OE9SAU/SAULink9_Node_Case/README.md

# SAULink9 Node Case
Front cover, back cover and base plate for aluminium housing (see partlist), fit all part´s you need to build up a SAULink9 Repeater Node for SVX- and EchoLink use.

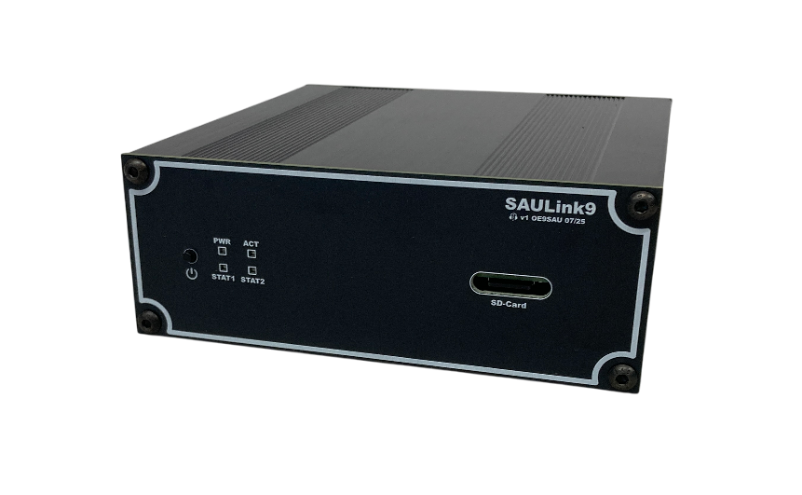
[picture p1: SAULink9_over_front.png]
Caseoverfront

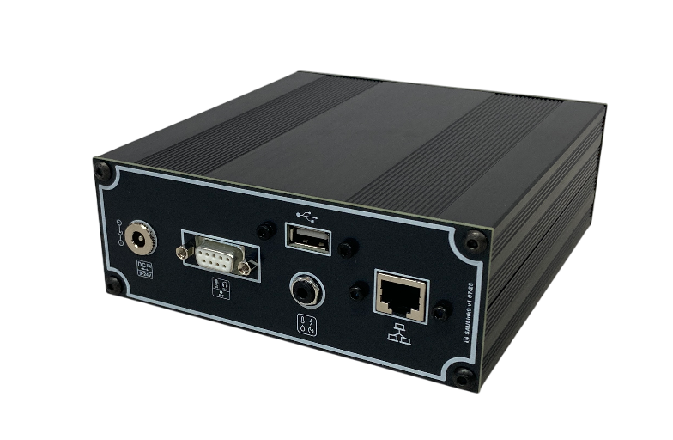
[picture p2: SAULink9_over_back.png]
Caseoverback
