OE9SAU/SAULink9_Node_Case/Node_assembly/SAULink9_Pinout.docx

1-Wire jack socket

1 | GND
2 | 5V
3 | Data
4 | ------

1-Wire jack plug

5V

Data

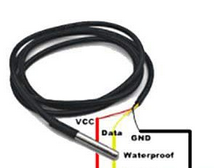
[picture p3: figure]

Sub-D (Blick von hinten auf die Buchse)

Sub-D | Farbe
1 | shield | GND
2 | black | PTT, Aktiv LOW
4 | red | CTCSS/SQL
7 | white | Output = TX Audio
9 | green | Input = RX Audio

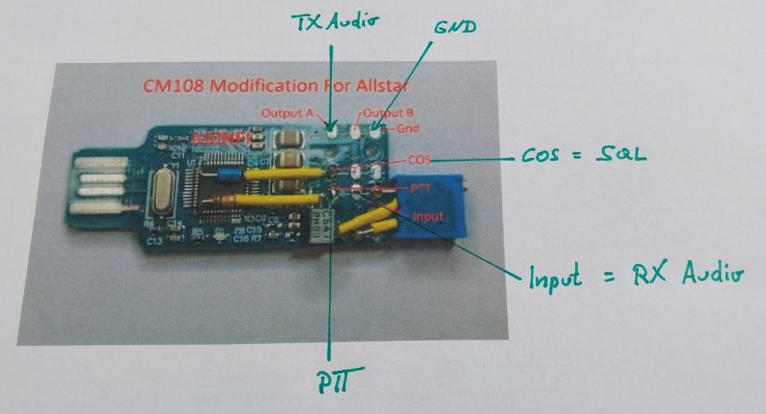
[picture p4: figure]

SAULink9 Pinout
