OE9SAU/SAULink9_Node_Case/Node_Case_back/DC_IN.png

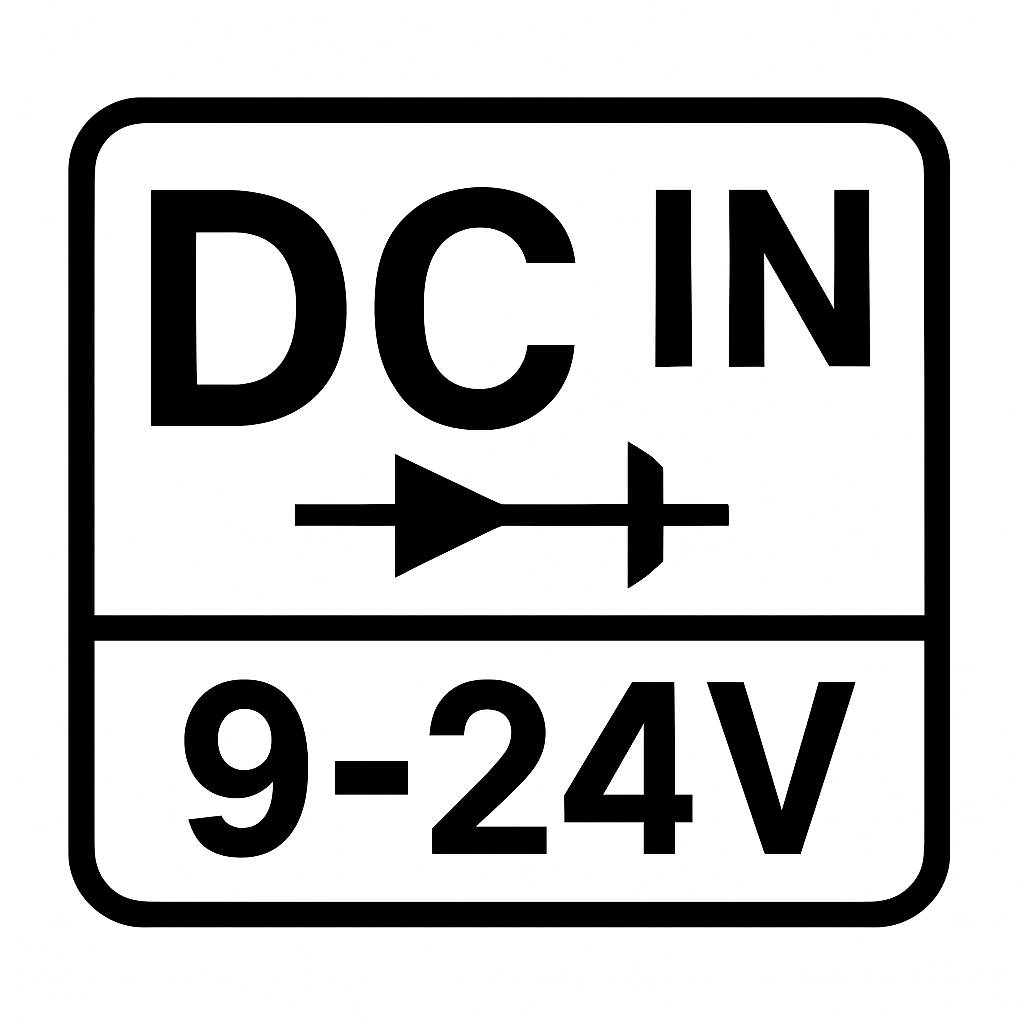
Node_Case_back/DC_IN.png
