OE9SAU/SAULink9_Node_Case/Node_Case_back/Hohlstecker-Polarität.png

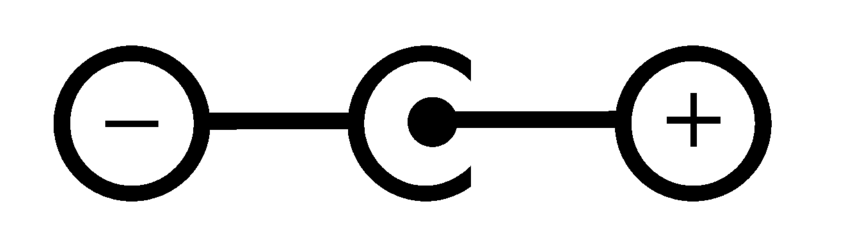
Node_Case_back/Hohlstecker-Polarität.png
