OE9SAU/SAULink9_Node_Case/Node_Case_back/IN_OUT.png

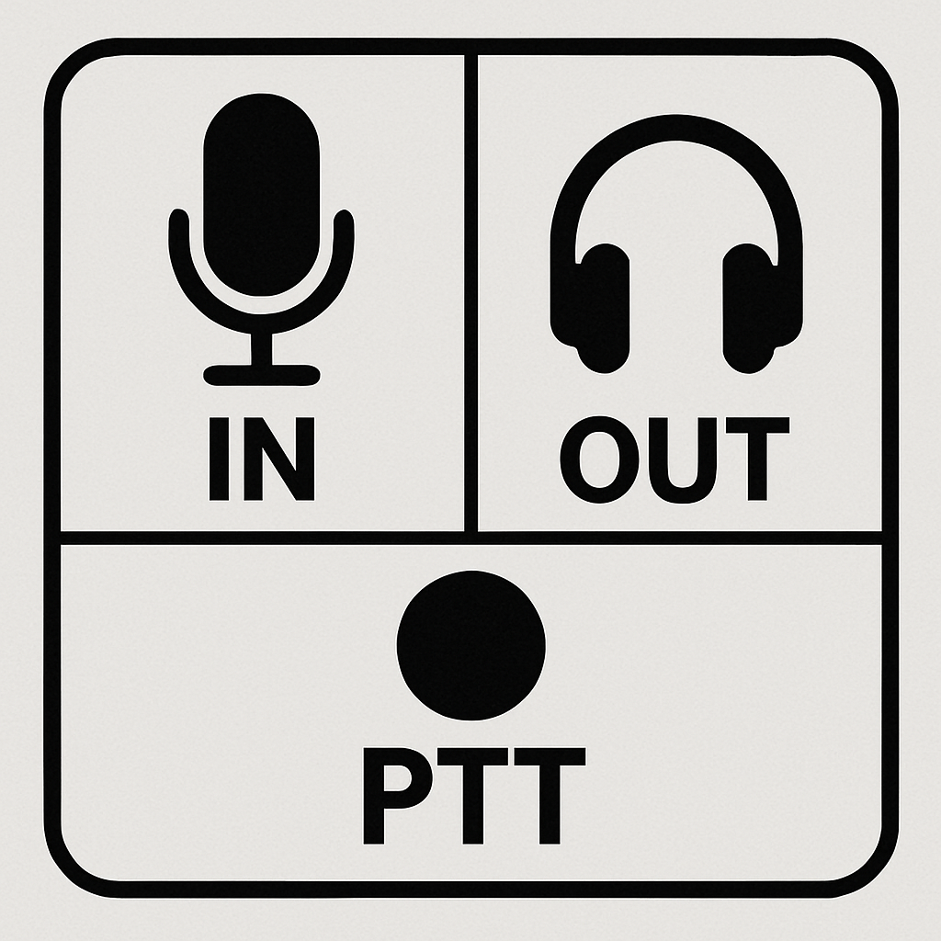
Node_Case_back/IN_OUT.png
