OE9SAU/SAULink9_Node_Case/Node_Case_back/iot.png

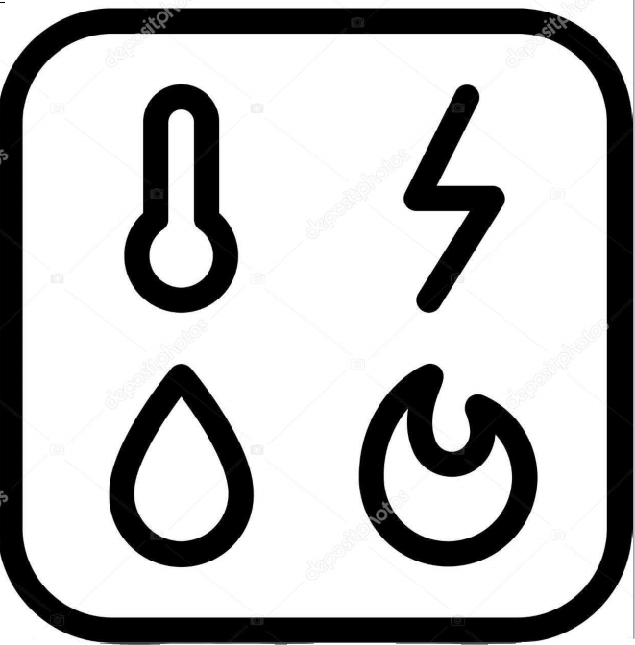
Node_Case_back/iot.png
