OE9SAU/SAULink9_Node_Case/Node_Case_back/lan-netzwerk.png

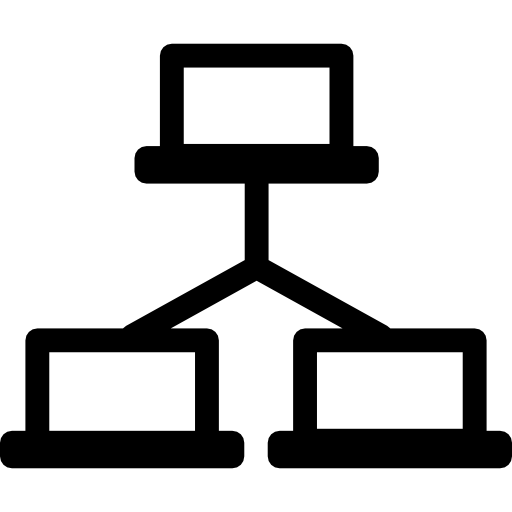
Node_Case_back/lan-netzwerk.png
