OE9SAU/SAULink9_Node_Case/Node_Case_back/on-off-button.png

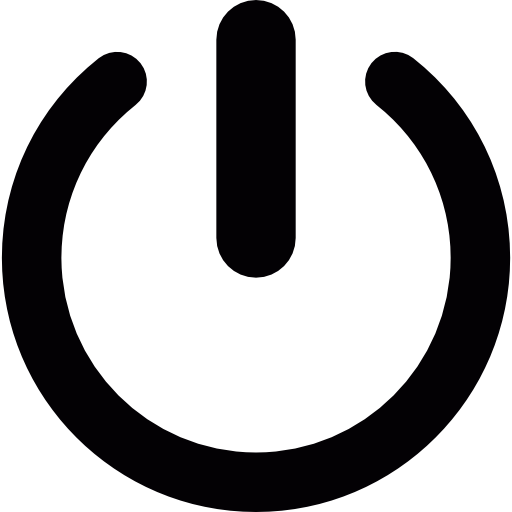
Node_Case_back/on-off-button.png
