OE9SAU/SAULink9_Node_Case/Node_Case_back/SAULink9_back.png

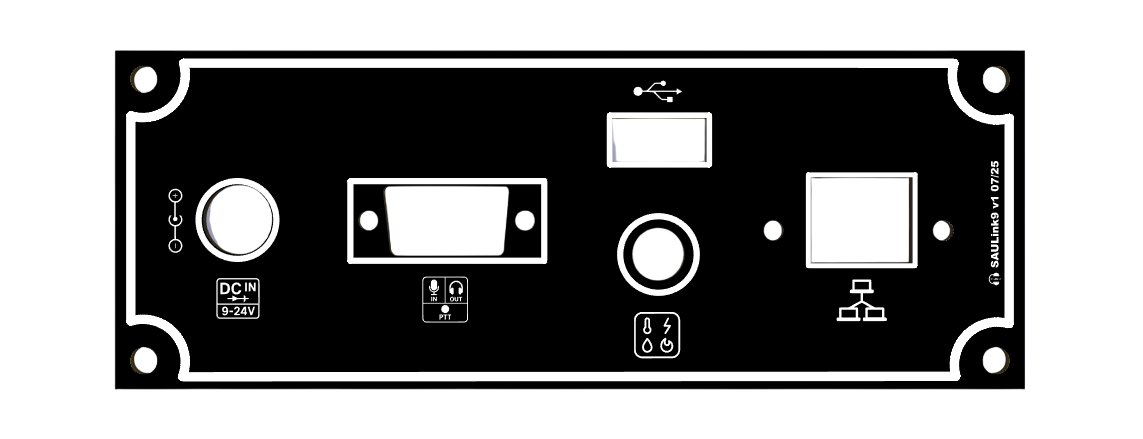
Node_Case_back/SAULink9_back.png
