OE9SAU/SAULink9_Node_Case/Node_Case_back/USB.png

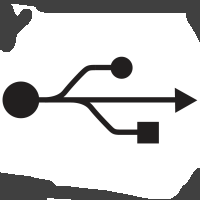
Node_Case_back/USB.png
