OE9SAU/SAULink9_Node_Case/Node_Case_baseplate/SAULink9_baseplate.png

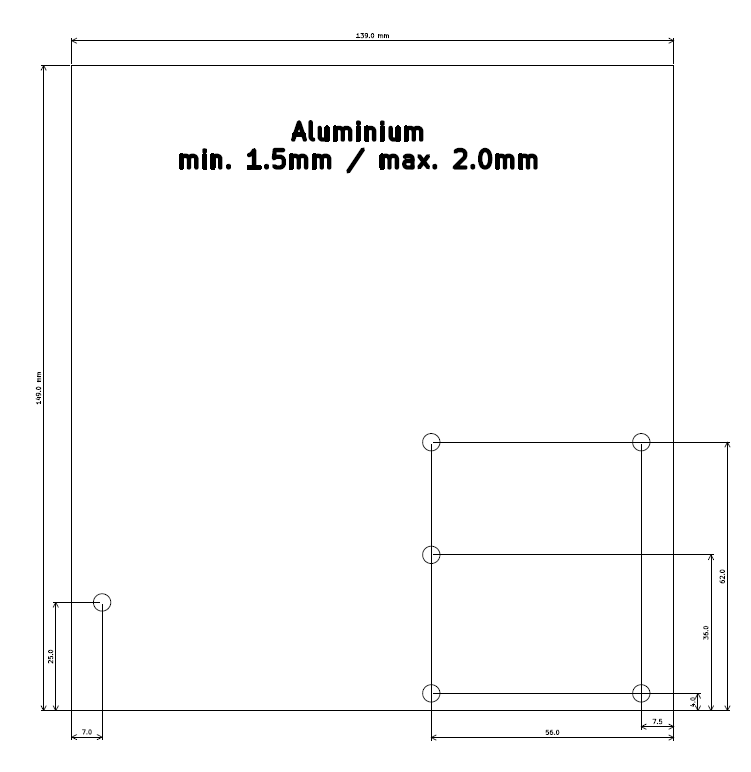
Node_Case_baseplate/SAULink9_baseplate.png
