OE9SAU/SAULink9_Node_Case/Node_Case_front/SAULink9_front.png

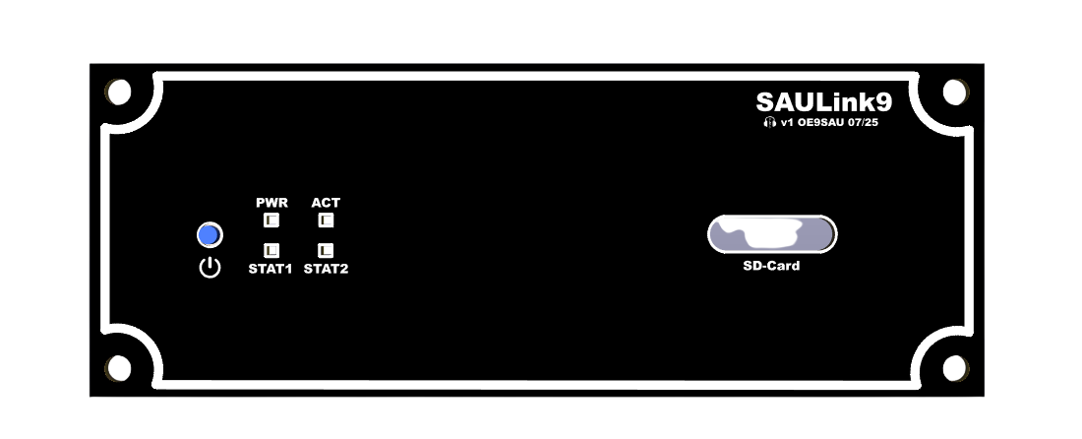
Node_Case_front/SAULink9_front.png
