OE9SAU/SAULink9_Node_Case/SAULink9_PartList.xlsx

Teile | Preis | Amazon
Alu Gehäuse 150*145*54 | EUR 20.56 | https://www.amazon.de/dp/B08DG2X7K5?ref=ppx_yo2ov_dt_b_fed_asin_title
Base plate for case |  | DIY
Front Panel | EUR 2.50 | https://github.com/OE9SAU/SVXLink_Node_Case
Back Panel | EUR 2.50 | https://github.com/OE9SAU/SVXLink_Node_Case
SVXLink Pi Hat | EUR 2.50 | https://github.com/OE9SAU/SVXLink_PiHat_v2
DC-DC 5V/5A | EUR 3.20 | https://www.amazon.de/dp/B0D1K83XRZ?ref=ppx_yo2ov_dt_b_fed_asin_title
USB-Soundcard | EUR 7.50 | https://www.amazon.de/dp/B087V62BYH?ref=ppx_yo2ov_dt_b_fed_asin_title
RJ45 plug to socket (30cm) | EUR 6.24 | https://www.amazon.de/dp/B01EF000NM?ref=ppx_yo2ov_dt_b_fed_asin_title
Klinkeneinbaubuchse | EUR 0.67 | https://www.amazon.de/dp/B09NDP25YY?ref=ppx_yo2ov_dt_b_fed_asin_title
USB Pigtail | EUR 1.41 | https://www.amazon.de/dp/B0D2VMSMGC?ref=ppx_yo2ov_dt_b_fed_asin_title&th=1
SD Card (16gb) | EUR 7.00 | https://www.amazon.de/gp/product/B08KSSX9PH/ref=ewc_pr_img_1?smid=A1G2FC5CI8M2YB&th=1
 |  | Reichelt
Rpi3b+ | EUR 38.22 | RASPBERRY PI 3B+
DC Einbaubuchse | EUR 1.21 | HEBLM 25
DC Stecker | EUR 0.23 | HS 25-9
D-Sub 9pol | EUR 0.18 | D-SUB BU 09
D-Sub Schraubsverriegelungssatz | EUR 1.16 | BKL 10120291
Schottkydiode, 30 V, 0,2 A, DO-35 | EUR 0.05 | BAT 43 STM
Bipolartransistor, NPN, 45V, 0,1A, 0,5W, TO-92 LF | EUR 0.07 | BC547CTA
Widerstand, Metallschicht, 4,70 kOhm, 0207, 0,6 W, 1% | EUR 0.07 | METALL 4,70K
Präzisionspotentiometer, 25 Gänge, liegend, 50 kOhm (nur bei Motorola) | EUR 0.24 | 64P-50K
JST - Buchsengehäuse, RM 2,5 mm, 1x6 polig, gew. - XH | EUR 0.45 | JST XH6P SM4
Taster, SMD, 1 Schließer (NO) | EUR 0.33 | OMR B3FS-1012P
Kleinmaterial SMD Widerstände, Abstandshalter, Drähte, usw. | EUR 10.00
 | EUR 106.29
