OE9SAU/SAULink9_Node_Case/Node_assembly/SAULink9_assembly.docx

1) mount DC-DC power supply to baseplate

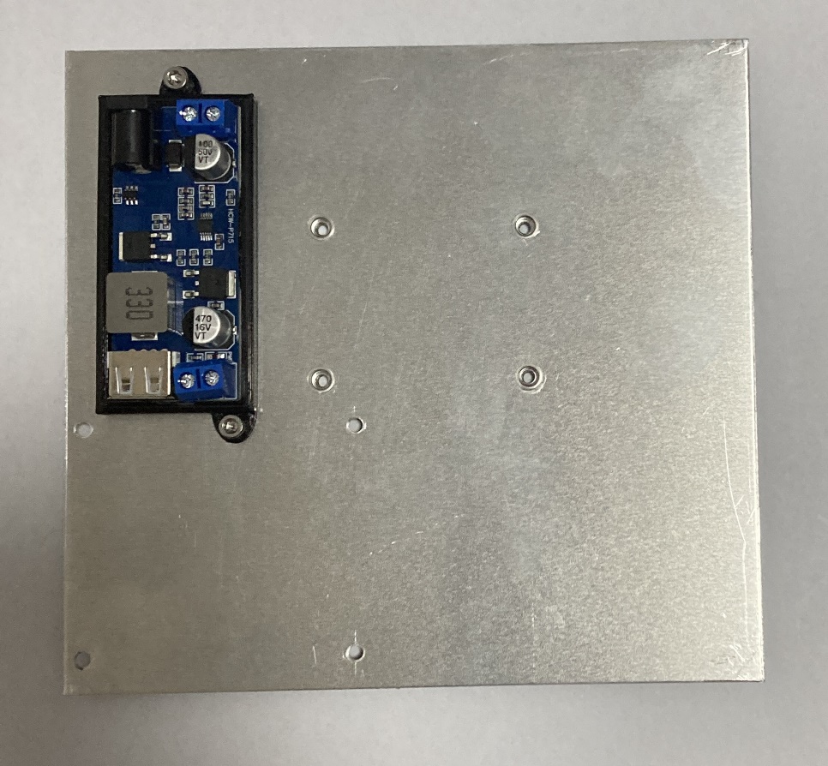
[picture p15: figure]

2) solder USB pigtail to RPI

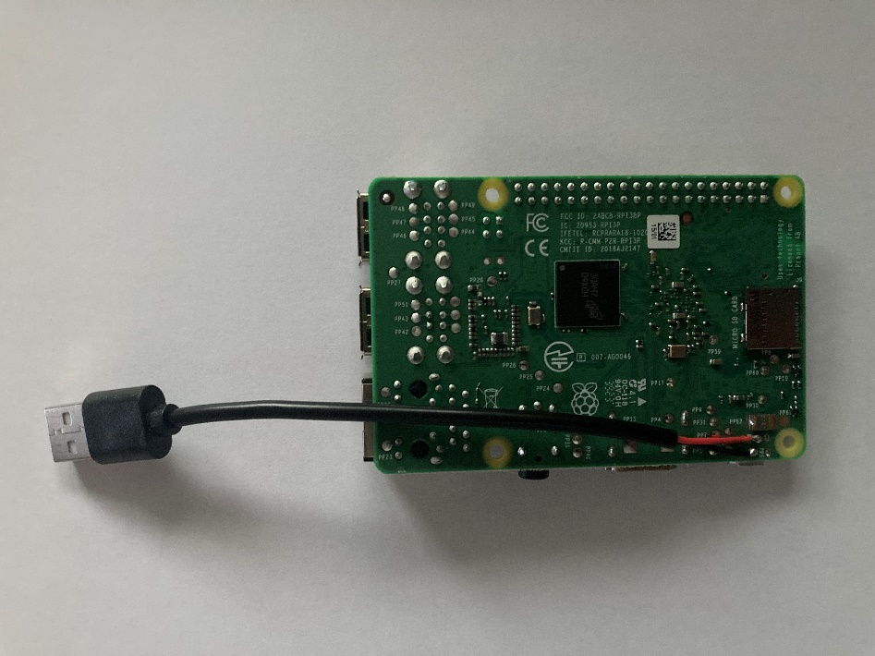
[picture p16: figure]
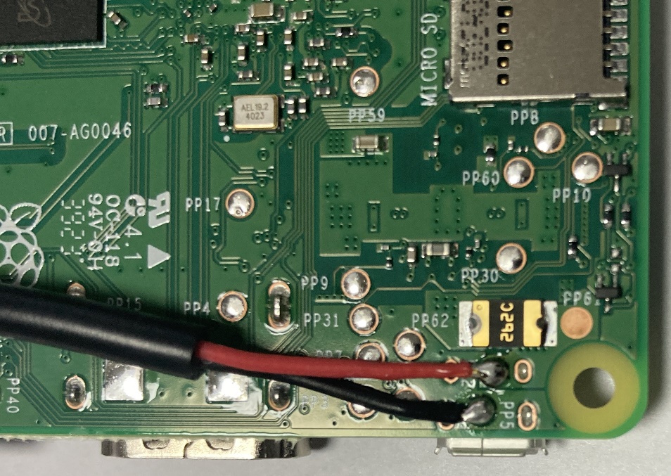
[picture p17: figure]
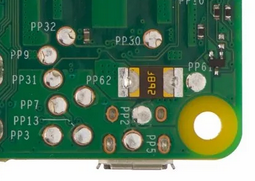
[picture p18: figure]

PP5 = GND (black) // PP2 = 5V (red)

3) Mount RPI with spacer to base plate

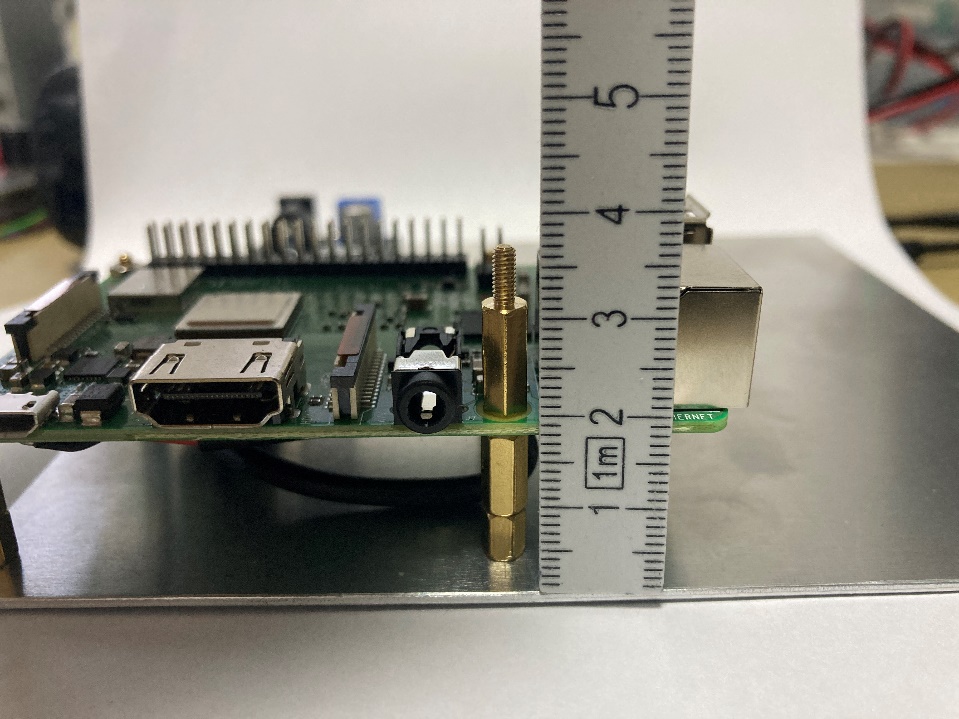
[picture p19: figure]

use 2.5x16+6 (4x) / 8x Nylon Flat // 2.5*12+6 (4x) / 2x M2.5 Nuts or similar high

4) Assemble and attach pihat to RPI with spacer (see above)

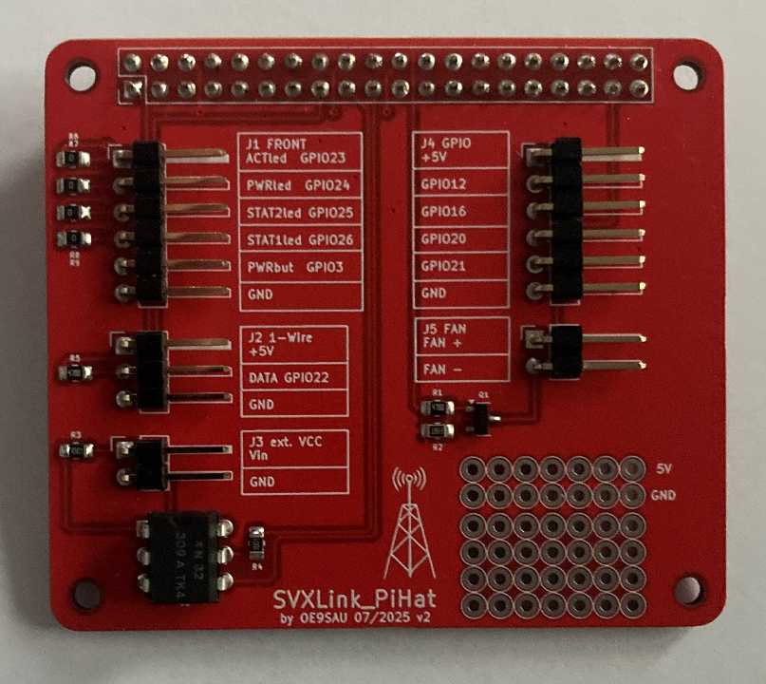
[picture p20: figure]
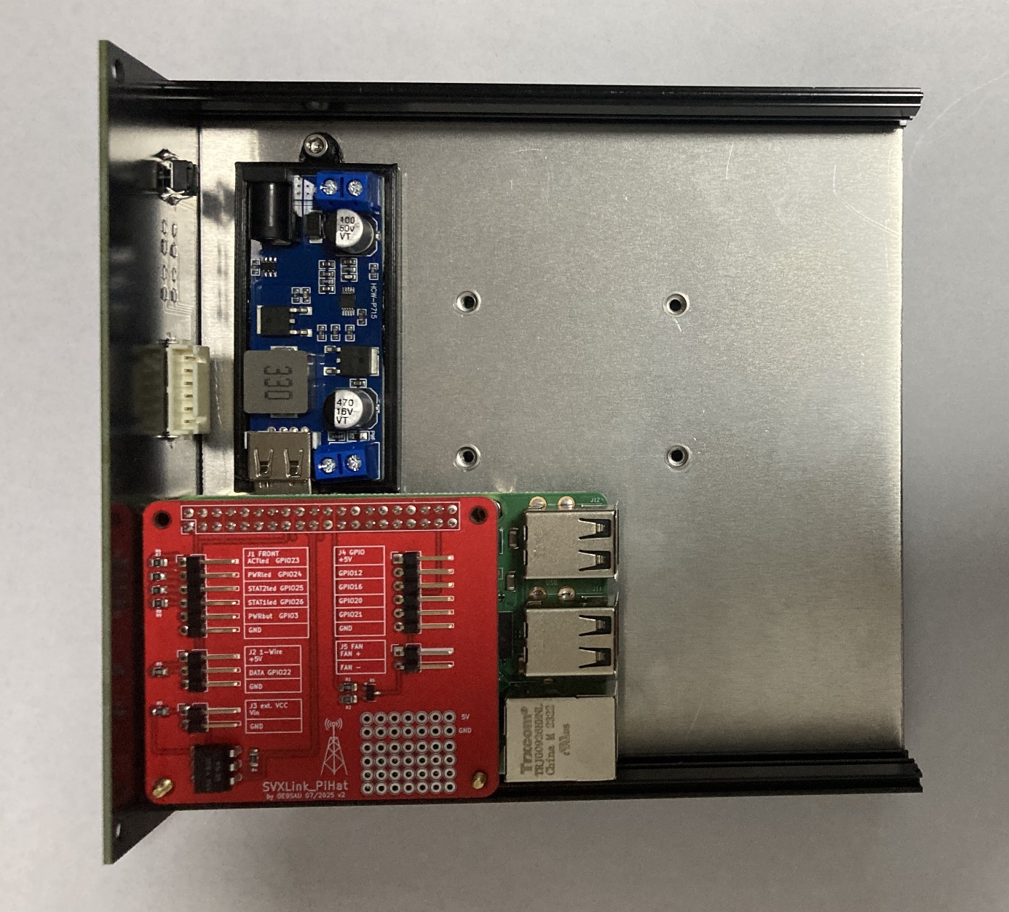
[picture p21: figure]

5) connecting front plate

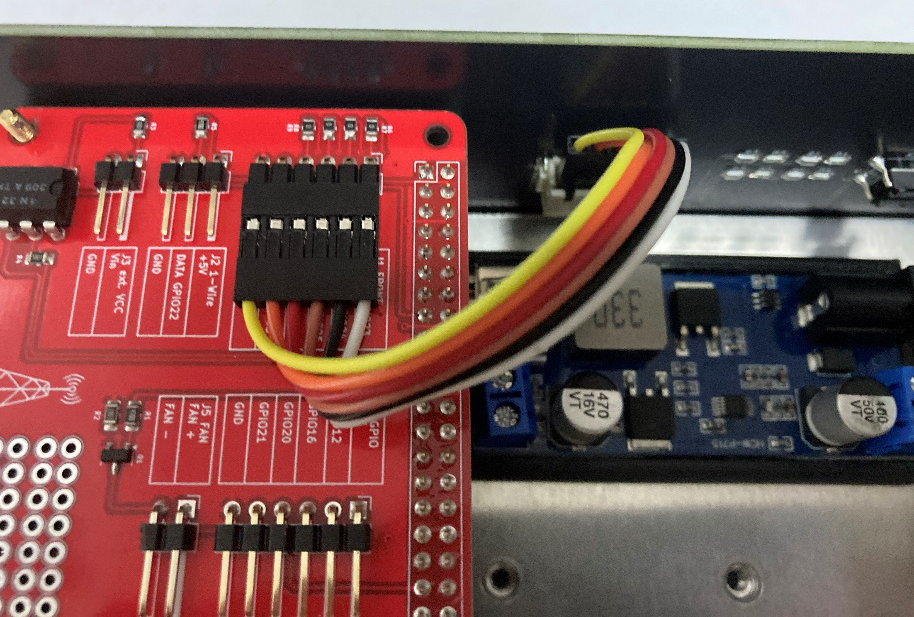
[picture p22: figure]
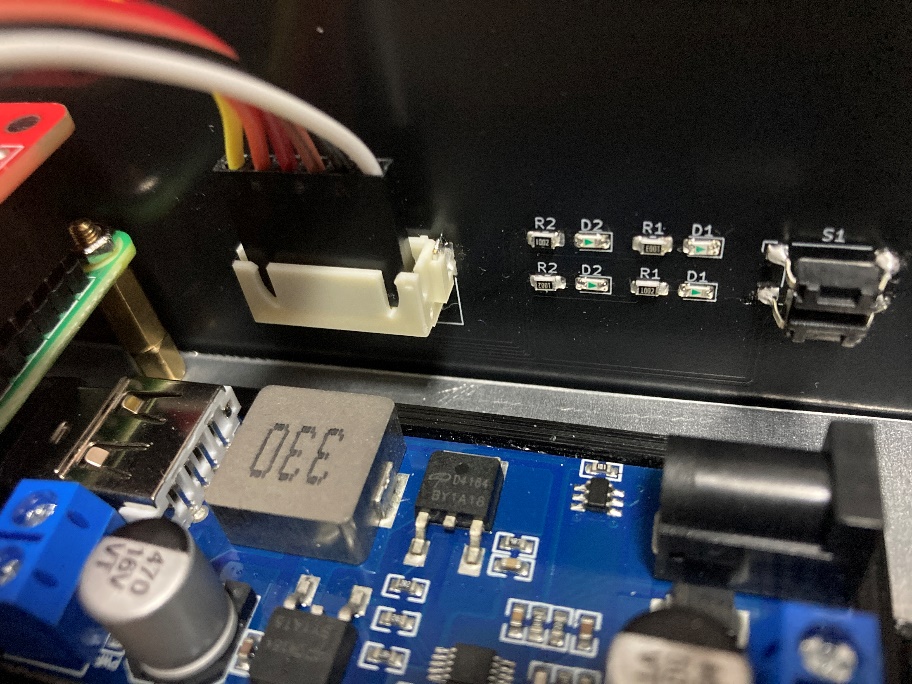
[picture p23: figure]
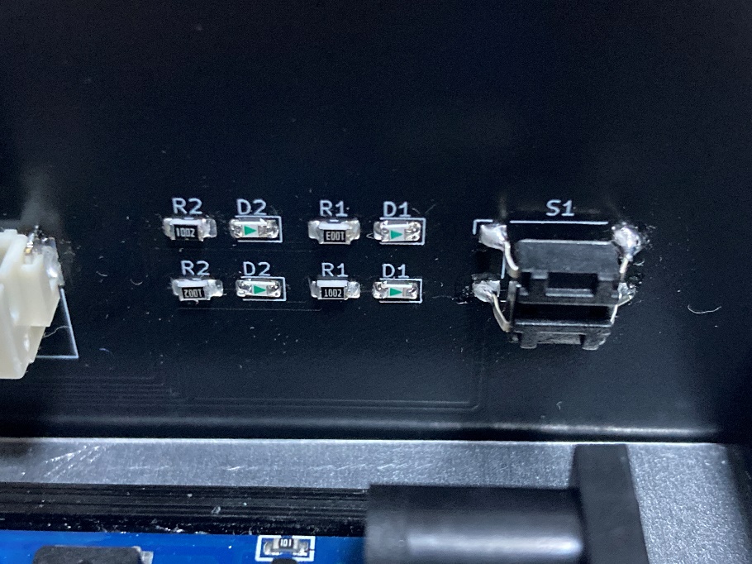
[picture p24: figure]

7) connectors for backplate

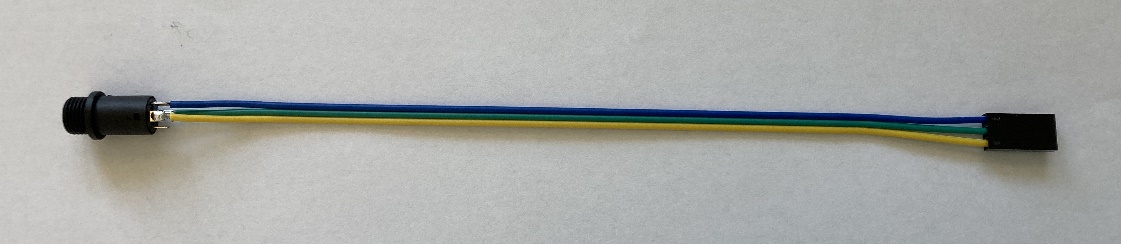
[picture p25: figure]

1-Wire jack socket

1 | GND
2 | 5V
3 | Data
4 | ------

1-Wire jack plug

5V

Data

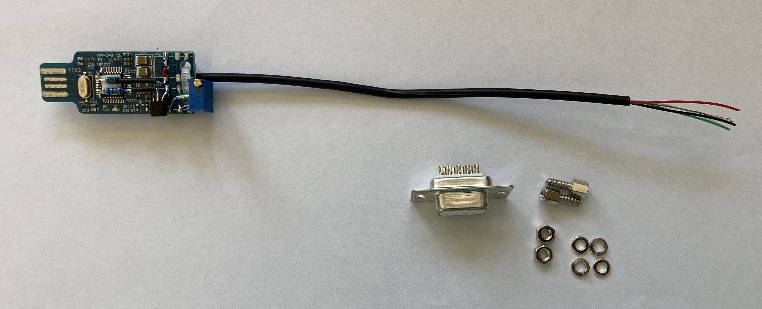
[picture p26: figure]
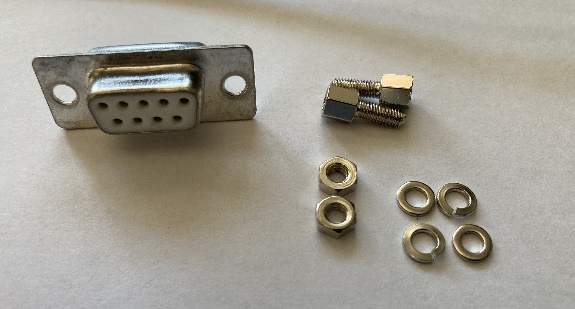
[picture p27: figure]

Sub-D | Farbe
1 | shield | GND
2 | black | PTT, Aktiv LOW
4 | red | CTCSS/SQL
7 | white | Output = TX Audio
9 | green | Input = RX Audio

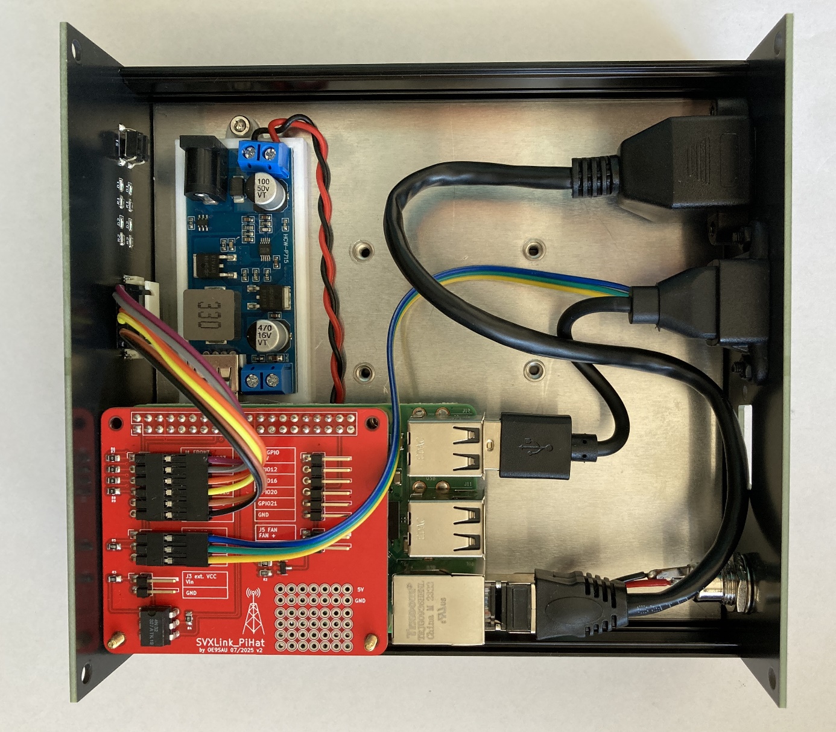
[picture p28: figure]

SAULink9 assembly
