OE9SAU/SAULink9_Node_Case/Node_assembly/pics/IMG_1199.JPG

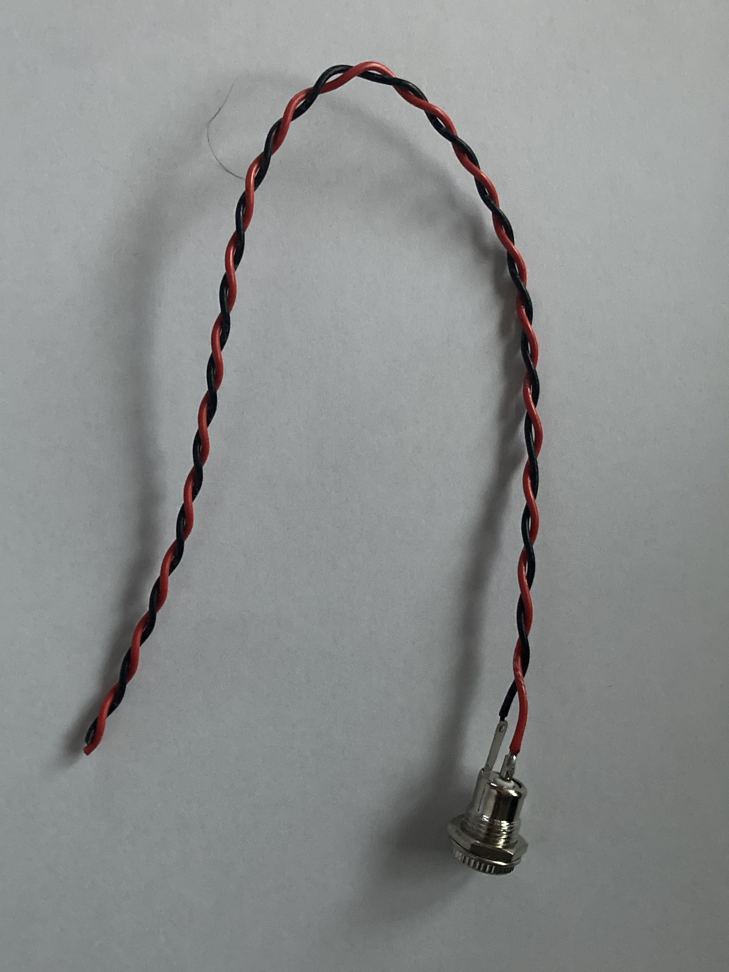
Node_assembly/pics/IMG_1199.JPG
