OE9SAU/SAULink9_Node_Case/(commit log)

2025-07-25 PCB upd
    [SVX_Node_Case_front.kicad_pcb]
2025-07-27 update pcb
    [SVX_Node_Case_back-B_Cu.gbr, SVX_Node_Case_back-B_Mask.gbr, SVX_Node_Case_back-B_Paste.gbr, SVX_Node_Case_back-B_Silkscreen.gbr, SVX_Node_Case_back-Edge_Cuts.gbr, SVX_Node_Case_back-F_Cu.gbr, SVX_Node_Case_back-F_Mask.gbr, SVX_Node_Case_back-F_Paste.gbr]
2025-08-02 readme upd
    [SAULink9_PartList.xlsx]
2025-08-27 update assembly
