OE9SAU/SAULink9_Node_Case/Node_assembly/pics/IMG_1196.JPG

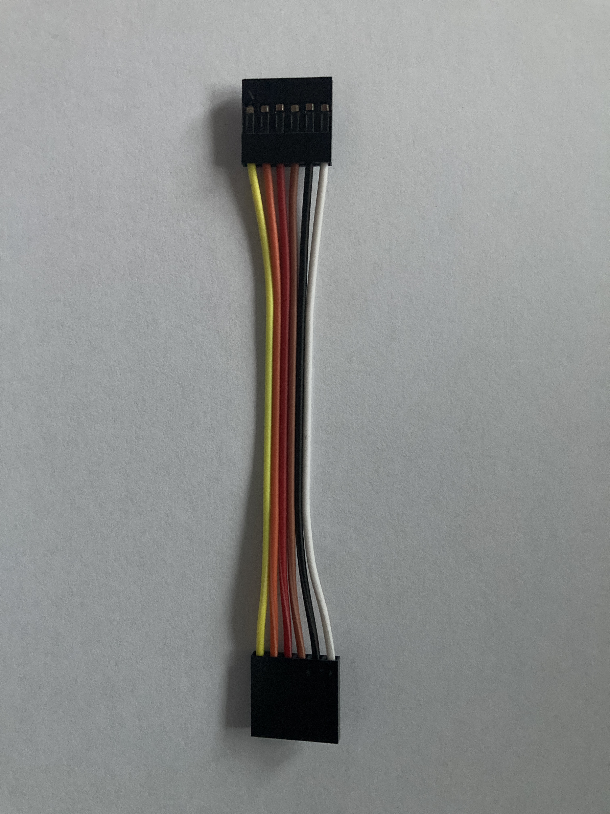
Node_assembly/pics/IMG_1196.JPG
